juremenart/matd/README.md

# 8x8 Acoustic levitator

Videos of prototype (2 x 8x8 boards with standing wave, done with data from this repo):

https://www.youtube.com/shorts/MVx3mwE5fvo

https://www.youtube.com/shorts/kOz_UAl6hNY

Levitation of 4 particles:

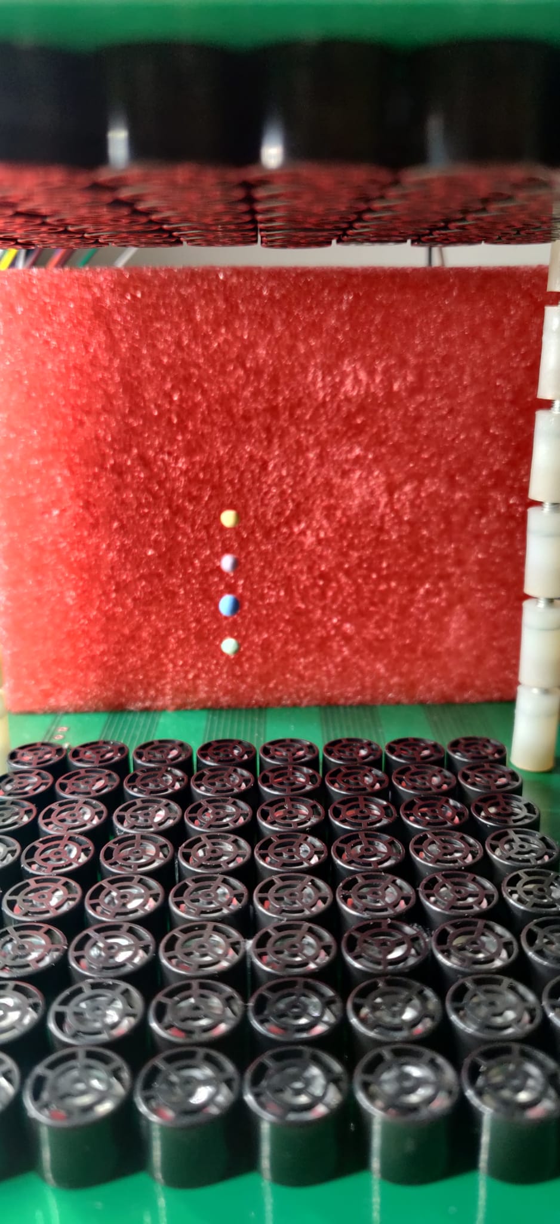
[picture p1: media/acoustic_levitation_9.jpg]
Title
