juremenart/matd/media/acoustic_levitation_8.jpg

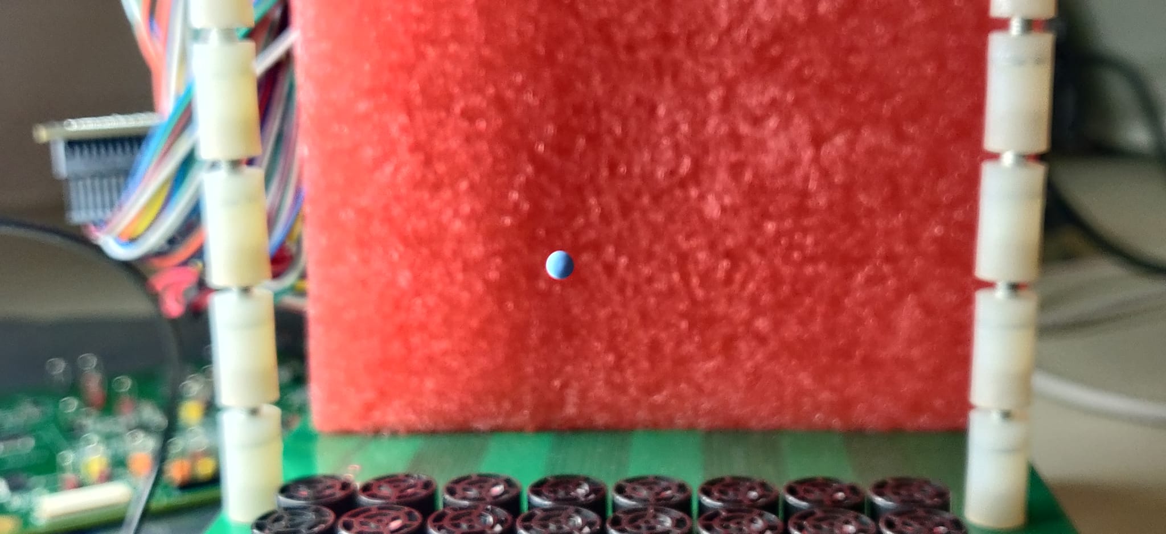
media/acoustic_levitation_8.jpg
