juremenart/matd/media/acoustic_levitation_boards_2.jpg

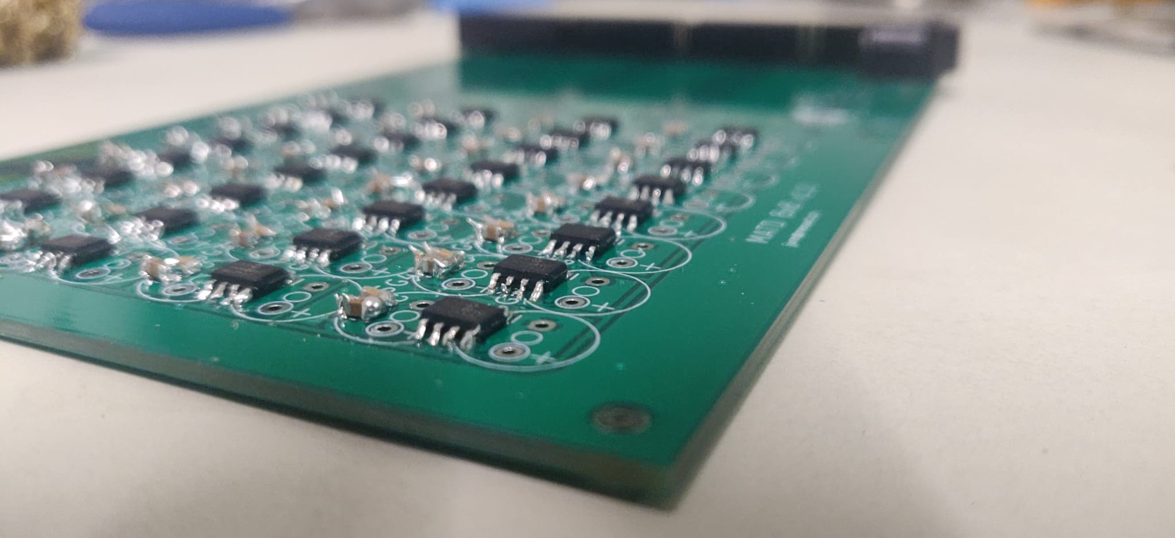
media/acoustic_levitation_boards_2.jpg
