juremenart/matd/media/acoustic_levitation_boards_3.jpg

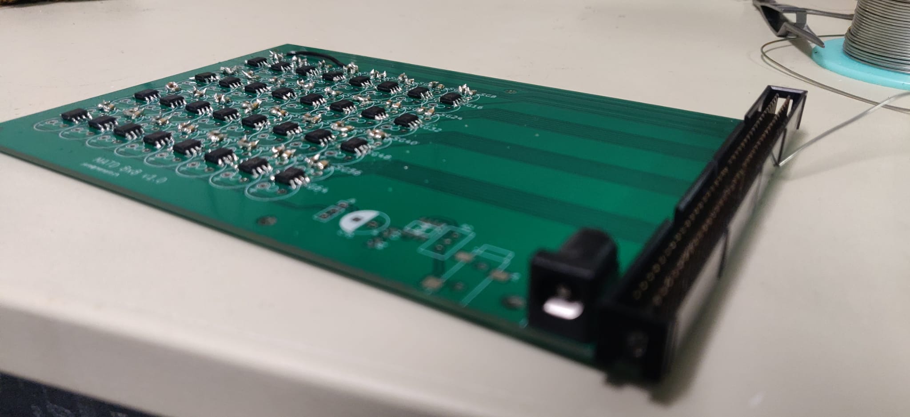
media/acoustic_levitation_boards_3.jpg
