juremenart/matd/media/acoustic_levitation_setup_1.jpg

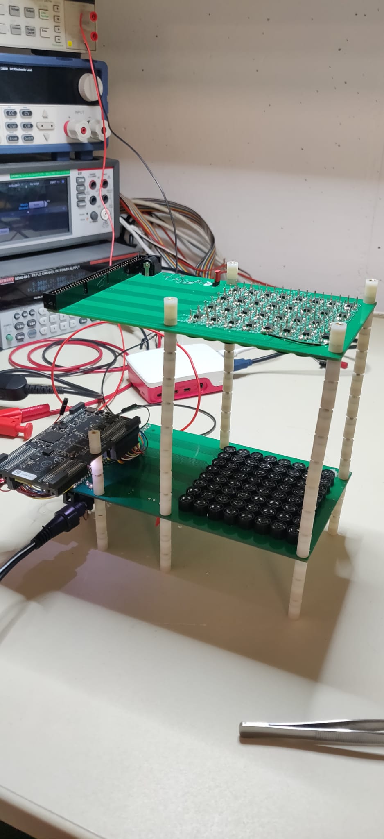
media/acoustic_levitation_setup_1.jpg
