juremenart/matd/media/acoustic_levitation_setup_2.jpg

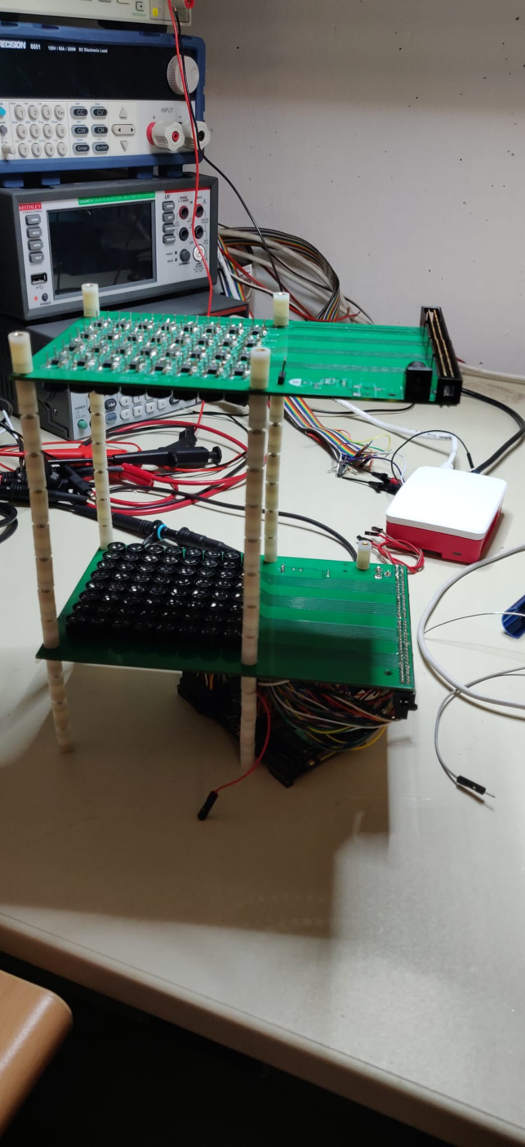
media/acoustic_levitation_setup_2.jpg
