juremenart/matd/(list of files, drawings)

Other design files:
pcb/matd_8x8/matd_8x8.dsn
