juremenart/matd/pcb/matd_8x8/matd_8x8.kicad_pcb

## KiCad design pcb/matd_8x8/matd_8x8.kicad_pcb (2023-04-12)

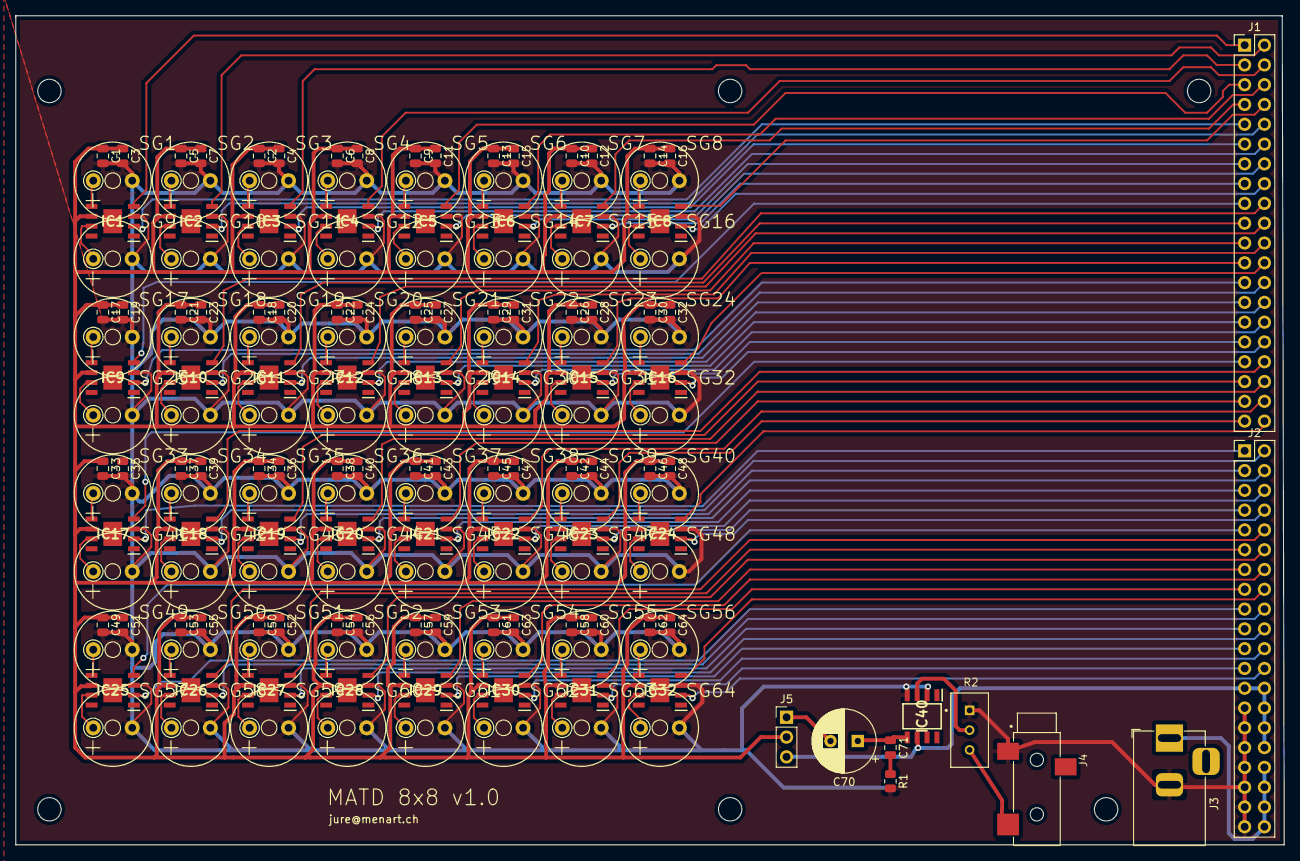
[picture p7: board matd_8x8.kicad_pcb from above]

Board: 2 copper layers, 162.8 x 106.4 mm, 170 parts (0 on the bottom side), 137 nets.

Parts:
C1, C3, C5, C7, C9, C11, C13, C15, C17, C19, C21, C23, C25, C27, C29, C31, C33, C35, C37, C39, C41, C43, C45, C47, C49, C51, C53, C55, C57, C59, C61, C63: 4u7F; C_0805_2012Metric
C2, C4, C6, C8, C10, C12, C14, C16, C18, C20, C22, C24, C26, C28, C30, C32, C34, C36, C38, C40, C42, C44, C46, C48, C50, C52, C54, C56, C58, C60, C62, C64: 0u1F; C_0805_2012Metric
C70: 270uF; CP_Radial_D8.0mm_P3.50mm
C71: 0.05uF; C_0805_2012Metric
IC1, IC2, IC3, IC4, IC5, IC6, IC7, IC8, IC9, IC10, IC11, IC12, IC13, IC14, IC15, IC16, IC17, IC18, IC19, IC20, IC21, IC22, IC23, IC24, IC25, IC26, IC27, IC28, IC29, IC30, IC31, IC32: TC4427AEOA; SOIC127P602X168-9N
IC40: LM386M-1_NOPB; SOIC127P600X175-8N
J1, J2: Conn_02x20_Odd_Even; PinHeader_2x20_P2.54mm_Vertical
J3: Barrel_Jack; BarrelJack_Horizontal
J4: SJ-3523-SMT-TR; CUI_SJ-3523-SMT-TR
J5: Conn_01x03_Male; PinHeader_1x03_P2.54mm_Vertical
R1: 10; R_0805_2012Metric
R2: 3296W-1-103LF; TRIM_3296W-1-103LF
SG1, SG2, SG3, SG4, SG5, SG6, SG7, SG8, SG9, SG10, SG11, SG12, SG13, SG14, SG15, SG16, SG17, SG18, SG19, SG20, SG21, SG22, SG23, SG24, SG25, SG26, SG27, SG28, SG29, SG30, SG31, SG32, SG33, SG34, SG35, SG36, SG37, SG38, SG39, SG40, SG41, SG42, SG43, SG44, SG45, SG46, SG47, SG48, SG49, SG50, SG51, SG52, SG53, SG54, SG55, SG56, SG57, SG58, SG59, SG60, SG61, SG62, SG63, SG64: BMT1205XH7.5

Connections:
/SG1_SG16/SG1_IN: IC1.4, J1.1
/SG1_SG16/SG2_IN: IC2.4, J1.2
/SG1_SG16/SG3_IN: IC3.4, J1.3
/SG1_SG16/SG4_IN: IC4.4, J1.4
/SG1_SG16/SG5_IN: IC5.4, J1.5
/SG1_SG16/SG6_IN: IC6.4, J1.6
/SG1_SG16/SG7_IN: IC7.4, J1.7
/SG1_SG16/SG8_IN: IC8.4, J1.8
/SG1_SG16/SG9_IN: IC1.2, J1.9
/SG1_SG16/SG10_IN: IC2.2, J1.10
/SG1_SG16/SG11_IN: IC3.2, J1.11
/SG1_SG16/SG12_IN: IC4.2, J1.12
/SG1_SG16/SG13_IN: IC5.2, J1.13
/SG1_SG16/SG14_IN: IC6.2, J1.14
/SG1_SG16/SG15_IN: IC7.2, J1.15
/SG1_SG16/SG16_IN: IC8.2, J1.16
/SG17_SG32/SG17_IN: IC9.4, J1.17
/SG17_SG32/SG18_IN: IC10.4, J1.18
/SG17_SG32/SG19_IN: IC11.4, J1.19
/SG17_SG32/SG20_IN: IC12.4, J1.20
/SG17_SG32/SG21_IN: IC13.4, J1.21
/SG17_SG32/SG22_IN: IC14.4, J1.22
/SG17_SG32/SG23_IN: IC15.4, J1.23
/SG17_SG32/SG24_IN: IC16.4, J1.24
/SG17_SG32/SG25_IN: IC9.2, J1.25
/SG17_SG32/SG26_IN: IC10.2, J1.26
/SG17_SG32/SG27_IN: IC11.2, J1.27
/SG17_SG32/SG28_IN: IC12.2, J1.28
/SG17_SG32/SG29_IN: IC13.2, J1.29
/SG17_SG32/SG30_IN: IC14.2, J1.30
/SG17_SG32/SG31_IN: IC15.2, J1.31
/SG17_SG32/SG32_IN: IC16.2, J1.32
/SG17_SG32/VCC: C1.1, C2.1, C3.1, C4.1, C5.1, C6.1, C7.1, C8.1, C9.1, C10.1, C11.1, C12.1, C13.1, C14.1, C15.1, C16.1, C17.1, C18.1, C19.1, C20.1, C21.1, C22.1, C23.1, C24.1, C25.1, C26.1, C27.1, C28.1, C29.1, C30.1, C31.1, C32.1, C33.1, C34.1, C35.1, C36.1, C37.1, C38.1, C39.1, C40.1, C41.1, C42.1, C43.1, C44.1, C45.1, C46.1, C47.1, C48.1, C49.1, C50.1, C51.1, C52.1, C53.1, C54.1, C55.1, C56.1, C57.1, C58.1, C59.1, C60.1, C61.1, C62.1, C63.1, C64.1, IC1.6, IC2.6, IC3.6, IC4.6, IC5.6, IC6.6, IC7.6, IC8.6, IC9.6, IC10.6, IC11.6, IC12.6, IC13.6, IC14.6, IC15.6, IC16.6, IC17.6, IC18.6, IC19.6, IC20.6, IC21.6, IC22.6, IC23.6, IC24.6, IC25.6, IC26.6, IC27.6, IC28.6, IC29.6, IC30.6, IC31.6, IC32.6, J5.2
/SG33_SG48/SG33_IN: IC17.4, J1.33
/SG33_SG48/SG34_IN: IC18.4, J1.34
/SG33_SG48/SG35_IN: IC19.4, J1.35
/SG33_SG48/SG36_IN: IC20.4, J1.36
/SG33_SG48/SG37_IN: IC21.4, J1.37
/SG33_SG48/SG38_IN: IC22.4, J1.38
/SG33_SG48/SG39_IN: IC23.4, J1.39
/SG33_SG48/SG40_IN: IC24.4, J1.40
/SG33_SG48/SG41_IN: IC17.2, J2.1
/SG33_SG48/SG42_IN: IC18.2, J2.2
/SG33_SG48/SG43_IN: IC19.2, J2.3
/SG33_SG48/SG44_IN: IC20.2, J2.4
/SG33_SG48/SG45_IN: IC21.2, J2.5
/SG33_SG48/SG46_IN: IC22.2, J2.6
/SG33_SG48/SG47_IN: IC23.2, J2.7
/SG33_SG48/SG48_IN: IC24.2, J2.8
/SG49_SG64/SG49_IN: IC25.4, J2.9
/SG49_SG64/SG50_IN: IC26.4, J2.10
/SG49_SG64/SG51_IN: IC27.4, J2.11
/SG49_SG64/SG52_IN: IC28.4, J2.12
/SG49_SG64/SG53_IN: IC29.4, J2.13
/SG49_SG64/SG54_IN: IC30.4, J2.14
/SG49_SG64/SG55_IN: IC31.4, J2.15
/SG49_SG64/SG56_IN: IC32.4, J2.16
/SG49_SG64/SG57_IN: IC25.2, J2.17
/SG49_SG64/SG58_IN: IC26.2, J2.18
/SG49_SG64/SG59_IN: IC27.2, J2.19
/SG49_SG64/SG60_IN: IC28.2, J2.20
/SG49_SG64/SG61_IN: IC29.2, J2.21
/SG49_SG64/SG62_IN: IC30.2, J2.22
/SG49_SG64/SG63_IN: IC31.2, J2.23
/SG49_SG64/SG64_IN: IC32.2, J2.24
GND: C1.2, C2.2, C3.2, C4.2, C5.2, C6.2, C7.2, C8.2, C9.2, C10.2, C11.2, C12.2, C13.2, C14.2, C15.2, C16.2, C17.2, C18.2, C19.2, C20.2, C21.2, C22.2, C23.2, C24.2, C25.2, C26.2, C27.2, C28.2, C29.2, C30.2, C31.2, C32.2, C33.2, C34.2, C35.2, C36.2, C37.2, C38.2, C39.2, C40.2, C41.2, C42.2, C43.2, C44.2, C45.2, C46.2, C47.2, C48.2, C49.2, C50.2, C51.2, C52.2, C53.2, C54.2, C55.2, C56.2, C57.2, C58.2, C59.2, C60.2, C61.2, C62.2, C63.2, C64.2, IC1.3, IC2.3, IC3.3, IC4.3, IC5.3, IC6.3, IC7.3, IC8.3, IC9.3, IC10.3, IC11.3, IC12.3, IC13.3, IC14.3, IC15.3, IC16.3, IC17.3, IC18.3, IC19.3, IC20.3, IC21.3, IC22.3, IC23.3, IC24.3, IC25.3, IC26.3, IC27.3, IC28.3, IC29.3, IC30.3, IC31.3, IC32.3, IC40.2, IC40.4, J2.27, J2.29, J2.31, J2.33, J2.35, J2.37, J2.39, J3.2, J4.1, R1.2, R2.1, SG1.-, SG2.-, SG3.-, SG4.-, SG5.-, SG6.-, SG7.-, SG8.-, SG9.-, SG10.-, SG11.-, SG12.-, SG13.-, SG14.-, SG15.-, SG16.-, SG17.-, SG18.-, SG19.-, SG20.-, SG21.-, SG22.-, SG23.-, SG24.-, SG25.-, SG26.-, SG27.-, SG28.-, SG29.-, SG30.-, SG31.-, SG32.-, SG33.-, SG34.-, SG35.-, SG36.-, SG37.-, SG38.-, SG39.-, SG40.-, SG41.-, SG42.-, SG43.-, SG44.-, SG45.-, SG46.-, SG47.-, SG48.-, SG49.-, SG50.-, SG51.-, SG52.-, SG53.-, SG54.-, SG55.-, SG56.-, SG57.-, SG58.-, SG59.-, SG60.-, SG61.-, SG62.-, SG63.-, SG64.-
unnamed: C70.1, C71.1, IC40.5
unnamed: C70.2, J5.1
unnamed: C71.2, R1.1
unnamed: IC1.5, SG1.+
unnamed: IC1.7, SG9.+
unnamed: IC2.5, SG2.+
unnamed: IC2.7, SG10.+
unnamed: IC3.5, SG3.+
unnamed: IC3.7, SG11.+
unnamed: IC4.5, SG4.+
unnamed: IC4.7, SG12.+
unnamed: IC5.5, SG5.+
unnamed: IC5.7, SG13.+
unnamed: IC6.5, SG6.+
unnamed: IC6.7, SG14.+
unnamed: IC7.5, SG7.+
unnamed: IC7.7, SG15.+
unnamed: IC8.5, SG8.+
unnamed: IC8.7, SG16.+
unnamed: IC9.5, SG17.+
unnamed: IC9.7, SG25.+
unnamed: IC10.5, SG18.+
unnamed: IC10.7, SG26.+
unnamed: IC11.5, SG19.+
unnamed: IC11.7, SG27.+
unnamed: IC12.5, SG20.+
unnamed: IC12.7, SG28.+
unnamed: IC13.5, SG21.+
unnamed: IC13.7, SG29.+
unnamed: IC14.5, SG22.+
unnamed: IC14.7, SG30.+
unnamed: IC15.5, SG23.+
unnamed: IC15.7, SG31.+
unnamed: IC16.5, SG24.+
unnamed: IC16.7, SG32.+
unnamed: IC17.5, SG33.+
unnamed: IC17.7, SG41.+
unnamed: IC18.5, SG34.+
unnamed: IC18.7, SG42.+
unnamed: IC19.5, SG35.+
unnamed: IC19.7, SG43.+
unnamed: IC20.5, SG36.+
unnamed: IC20.7, SG44.+
unnamed: IC21.5, SG37.+
unnamed: IC21.7, SG45.+
unnamed: IC22.5, SG38.+
unnamed: IC22.7, SG46.+
unnamed: IC23.5, SG39.+
unnamed: IC23.7, SG47.+
unnamed: IC24.5, SG40.+
unnamed: IC24.7, SG48.+
unnamed: IC25.5, SG49.+
unnamed: IC25.7, SG57.+
unnamed: IC26.5, SG50.+
unnamed: IC26.7, SG58.+
unnamed: IC27.5, SG51.+
unnamed: IC27.7, SG59.+
unnamed: IC28.5, SG52.+
unnamed: IC28.7, SG60.+
unnamed: IC29.5, SG53.+
unnamed: IC29.7, SG61.+
unnamed: IC30.5, SG54.+
unnamed: IC30.7, SG62.+
unnamed: IC31.5, SG55.+
unnamed: IC31.7, SG63.+
unnamed: IC32.5, SG56.+
unnamed: IC32.7, SG64.+
unnamed: IC40.3, R2.2
unnamed: IC40.6, J2.25, J2.26, J2.28, J2.30, J2.32, J5.3
unnamed: J2.34, J2.36, J2.38, J2.40, J3.1
unnamed: J4.2, R2.3
