juremenart/matd/fpga/constr/pwm_num_125.xdc

# Location contraints

# PWM outputs

# JB2.4
set_property PACKAGE_PIN    R19         [get_ports {pwm[0]}]
set_property IOSTANDARD     LVCMOS33    [get_ports {pwm[0]}]

# JB2.5
set_property PACKAGE_PIN    N17         [get_ports {pwm[1]}]
set_property IOSTANDARD     LVCMOS33    [get_ports {pwm[1]}]

# JB2.6
set_property PACKAGE_PIN    P16         [get_ports {pwm[2]}]
set_property IOSTANDARD     LVCMOS33    [get_ports {pwm[2]}]

# JB2.7
set_property PACKAGE_PIN    P18         [get_ports {pwm[3]}]
set_property IOSTANDARD     LVCMOS33    [get_ports {pwm[3]}]

# JB2.8
set_property PACKAGE_PIN    P15         [get_ports {pwm[4]}]
set_property IOSTANDARD     LVCMOS33    [get_ports {pwm[4]}]

# JB2.11
set_property PACKAGE_PIN    T17         [get_ports {pwm[5]}]
set_property IOSTANDARD     LVCMOS33    [get_ports {pwm[5]}]

# JB2.12
set_property PACKAGE_PIN    R17         [get_ports {pwm[6]}]
set_property IOSTANDARD     LVCMOS33    [get_ports {pwm[6]}]

# JB2.13
set_property PACKAGE_PIN    R18         [get_ports {pwm[7]}]
set_property IOSTANDARD     LVCMOS33    [get_ports {pwm[7]}]

# JB2.14
set_property PACKAGE_PIN    R16         [get_ports {pwm[8]}]
set_property IOSTANDARD     LVCMOS33    [get_ports {pwm[8]}]

# JB2.17
set_property PACKAGE_PIN    V17         [get_ports {pwm[9]}]
set_property IOSTANDARD     LVCMOS33    [get_ports {pwm[9]}]

# JB2.18
set_property PACKAGE_PIN    W19         [get_ports {pwm[10]}]
set_property IOSTANDARD     LVCMOS33    [get_ports {pwm[10]}]

# JB2.19
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

# JA1.37
set_property PACKAGE_PIN    H18         [get_ports {pwm[123]}]
set_property IOSTANDARD     LVCMOS33    [get_ports {pwm[123]}]

# JA1.38
set_property PACKAGE_PIN    H16         [get_ports {pwm[124]}]
set_property IOSTANDARD     LVCMOS33    [get_ports {pwm[124]}]
